jgalentine007/esp8266_derby_timer/(commit log)

2016-11-04 Add alphanumeric display, piezo, fixes.
    [derby_timer.ino]
2016-12-28 Change pin 15 to falling
2018-01-13 Rewrite to use switch for starting derby instead of countdown timer.
2018-01-13 Add additional race ready step to deal with switch bouncing.
